IKGB105/LM2596-Adjustable-Buck-Converter/fem/figuras/12V_acercamiento_U1_D1.png

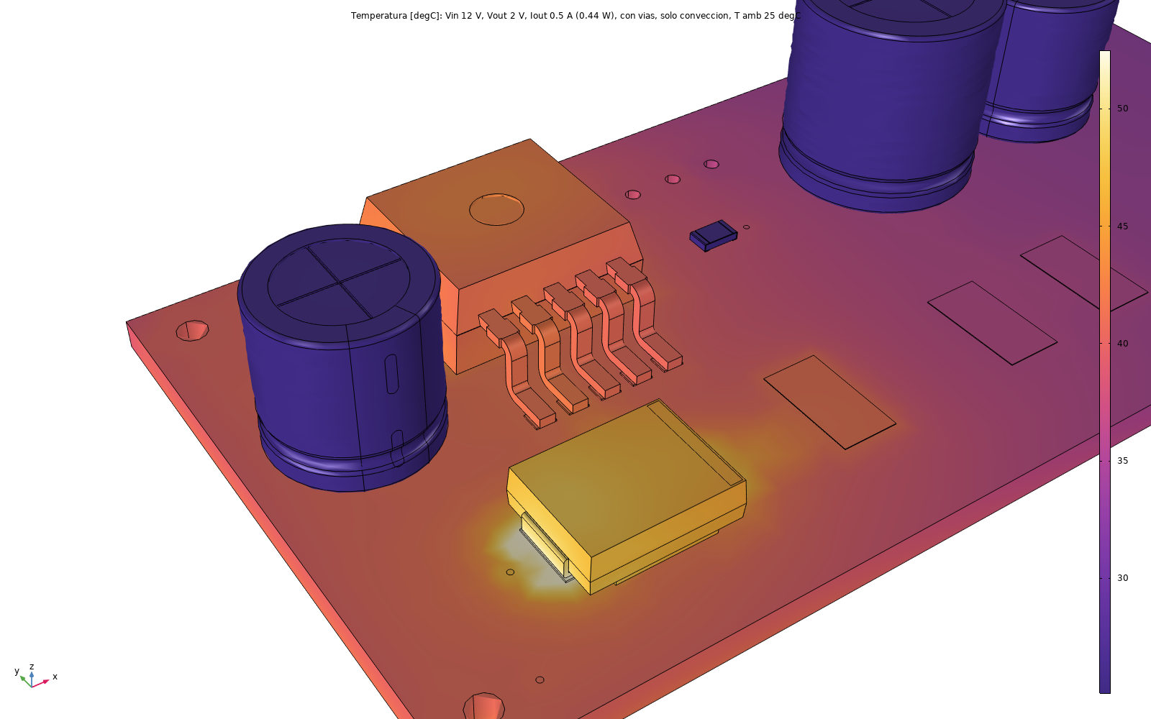
fem/figuras/12V_acercamiento_U1_D1.png
