IKGB105/LM2596-Adjustable-Buck-Converter/fem/figuras/12V_inferior.png

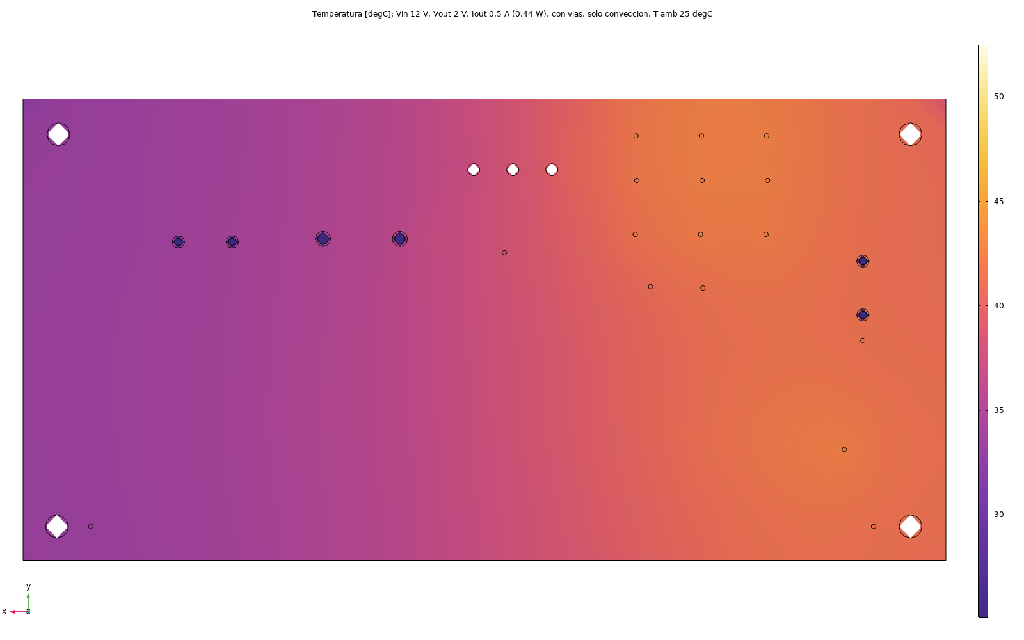
fem/figuras/12V_inferior.png
