IKGB105/LM2596-Adjustable-Buck-Converter/fem/figuras/aire_corte_temperatura.png

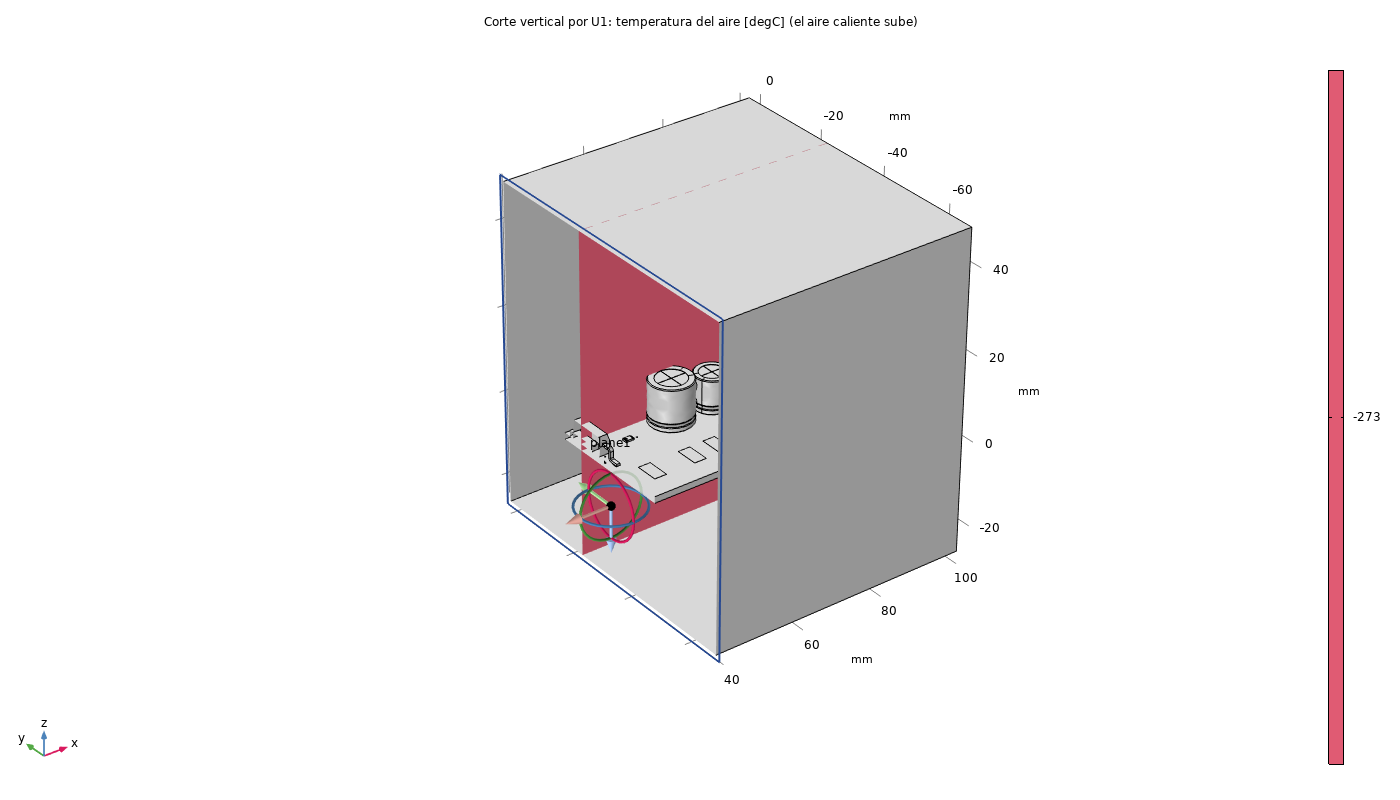
fem/figuras/aire_corte_temperatura.png
