IKGB105/LM2596-Adjustable-Buck-Converter/fem/geometria/LM259.step

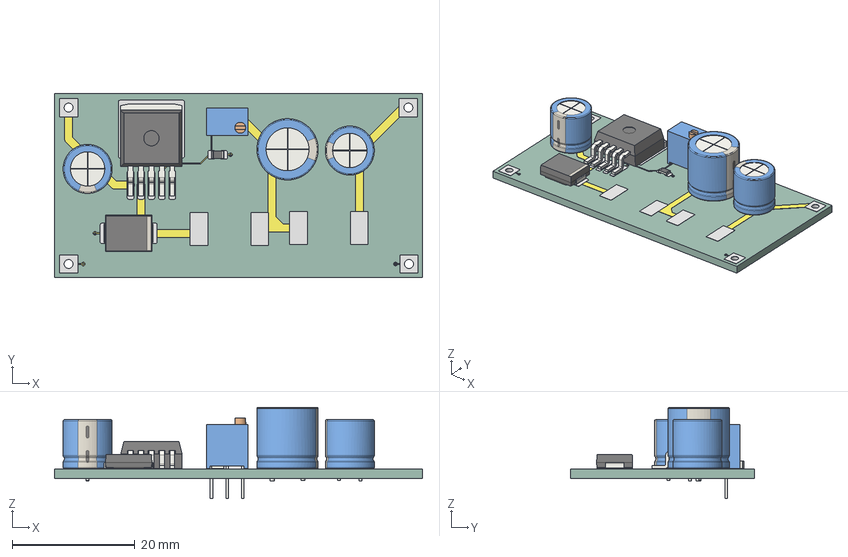
[picture p11: CAD file, 2026-10-22]
fem/geometria/LM259.step
60.0 x 30.0 x 14.9 mm
CP_Radial_D80mm_P350mm x 2
Potentiometer_Bourns_3266Y_Vertical
a648ce37-9c39-11ed-93f0-dde97e994e83_part
a648ce38-9c39-11ed-93f0-dde97e994e83_part
a648ce39-9c39-11ed-93f0-dde97e994e83_part
CP_Radial_D100mm_P500mm
R_0805_2012Metric
D_SMC
LM259-unsaved-export-bPfgib_copper
LM259-unsaved-export-bPfgib_pad
LM259-unsaved-export-bPfgib_via
LM259-unsaved-export-bPfgib_PCB
