IKGB105/LM2596-Adjustable-Buck-Converter/fem/geometria/Arreglo.step

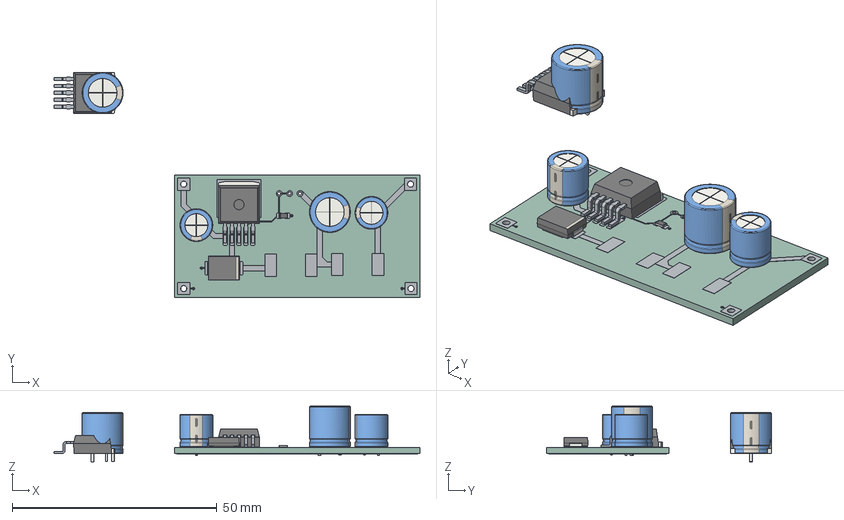
[picture p12: CAD file, 2026-10-22]
fem/geometria/Arreglo.step
89.4 x 55.0 x 13.6 mm
CP_Radial_D80mm_P350mm x 6
X-axis x 39
XY-plane x 39
a648ce37-9c39-11ed-93f0-dde97e994e83_part x 6
a648ce38-9c39-11ed-93f0-dde97e994e83_part x 6
a648ce39-9c39-11ed-93f0-dde97e994e83_part x 6
CP_Radial_D100mm_P500mm x 3
R_0805_2012Metric x 3
D_SMC x 3
LM259-unsaved-export-bPfgib_copper x 2
LM259-unsaved-export-bPfgib_pad x 2
LM259-unsaved-export-bPfgib_via x 2
LM259-unsaved-export-bPfgib_PCB x 2
