IKGB105/LM2596-Adjustable-Buck-Converter/fem/geometria/dominios_materiales_STEP.csv

dominio | material | que es
1 | FR4 (placa) | Placa
2 | Cobre (tab y pines de U1, pads de L1/L2) | Lamina de cobre (pista, pad o plano)
3 | Cobre (tab y pines de U1, pads de L1/L2) | Lamina de cobre (pista, pad o plano)
4 | Cobre (tab y pines de U1, pads de L1/L2) | Lamina de cobre (pista, pad o plano)
5 | Cobre (tab y pines de U1, pads de L1/L2) | Lamina de cobre (pista, pad o plano)
6 | Cobre (tab y pines de U1, pads de L1/L2) | Lamina de cobre (pista, pad o plano)
7 | Cobre (tab y pines de U1, pads de L1/L2) | Lamina de cobre (pista, pad o plano)
8 | Cobre (tab y pines de U1, pads de L1/L2) | Lamina de cobre (pista, pad o plano)
9 | Cobre (tab y pines de U1, pads de L1/L2) | Lamina de cobre (pista, pad o plano)
10 | Cobre (tab y pines de U1, pads de L1/L2) | Barril de agujero THT (diam 1.50 mm)
11 | Cobre (tab y pines de U1, pads de L1/L2) | Lamina de cobre (pista, pad o plano)
12 | Cobre (tab y pines de U1, pads de L1/L2) | Lamina de cobre (pista, pad o plano)
13 | Cobre (tab y pines de U1, pads de L1/L2) | Lamina de cobre (pista, pad o plano)
14 | Cobre (tab y pines de U1, pads de L1/L2) | Lamina de cobre (pista, pad o plano)
15 | Cobre (tab y pines de U1, pads de L1/L2) | Barril de agujero THT (diam 1.50 mm)
16 | Cobre (tab y pines de U1, pads de L1/L2) | Lamina de cobre (pista, pad o plano)
17 | Cobre (tab y pines de U1, pads de L1/L2) | Lamina de cobre (pista, pad o plano)
18 | Relleno generico (C1-C3, R1) | Capacitor
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
187 | Cobre (tab y pines de U1, pads de L1/L2) | Lamina de cobre (pista, pad o plano)
188 | Cobre (tab y pines de U1, pads de L1/L2) | Lamina de cobre (pista, pad o plano)
189 | Cobre (tab y pines de U1, pads de L1/L2) | Lamina de cobre (pista, pad o plano)
190 | Cobre (tab y pines de U1, pads de L1/L2) | Lamina de cobre (pista, pad o plano)
191 | Cobre (tab y pines de U1, pads de L1/L2) | Lamina de cobre (pista, pad o plano)
192 | Cobre (tab y pines de U1, pads de L1/L2) | Lamina de cobre (pista, pad o plano)
193 | Cobre (tab y pines de U1, pads de L1/L2) | Barril de agujero THT (diam 1.50 mm)
194 | Cobre (tab y pines de U1, pads de L1/L2) | Lamina de cobre (pista, pad o plano)
195 | Cobre (tab y pines de U1, pads de L1/L2) | Lamina de cobre (pista, pad o plano)
196 | Cobre (tab y pines de U1, pads de L1/L2) | Barril de agujero THT (diam 1.50 mm)
197 | Cobre (tab y pines de U1, pads de L1/L2) | Lamina de cobre (pista, pad o plano)
198 | Cobre (tab y pines de U1, pads de L1/L2) | Lamina de cobre (pista, pad o plano)
199 | Cobre (tab y pines de U1, pads de L1/L2) | Lamina de cobre (pista, pad o plano)
