IKGB105/LM2596-Adjustable-Buck-Converter/fem/resultados/barrido_corriente.csv

Iout [A] | P_U1 [W] | P_D1 [W] | P_L1 [W] | P_L2 [W] | P_tot [W] | T union U1 (cara tab-cuerpo) [degC] | T max U1 [degC] | T max D1 [degC] | T max placa [degC] | T max en todo [degC]
0.5 | 0.335 | 0.237 | 0.010 | 0.006 | 0.589 | 50.4 | 50.4 | 58.9 | 58.9 | 58.9
1 | 0.496 | 0.475 | 0.040 | 0.025 | 1.036 | 63.8 | 63.8 | 85.4 | 85.4 | 85.4
1.5 | 0.656 | 0.712 | 0.090 | 0.056 | 1.515 | 77.0 | 77.0 | 111.4 | 111.3 | 111.4
2 | 0.817 | 0.950 | 0.160 | 0.100 | 2.026 | 90.0 | 90.0 | 136.9 | 136.9 | 136.9
2.5 | 0.977 | 1.187 | 0.250 | 0.156 | 2.571 | 103.1 | 103.1 | 162.5 | 162.4 | 162.5
3 | 1.138 | 1.424 | 0.360 | 0.225 | 3.147 | 116.2 | 116.2 | 187.9 | 187.8 | 187.9
