IKGB105/LM2596-Adjustable-Buck-Converter/fem/resultados/variantes.csv

variante | T union U1 (cara tab-cuerpo) [degC] | T max U1 [degC] | T max D1 [degC] | T max placa [degC] | T max en todo [degC]
Con vias (base) | 116.2 | 116.2 | 187.9 | 187.8 | 187.9
Sin vias | 123.8 | 123.8 | 205.2 | 205.0 | 205.2
Con vias + radiacion (eps 0.9) | 89.3 | 89.3 | 155.8 | 155.7 | 155.8
Sin vias + radiacion (eps 0.9) | 96.7 | 96.7 | 170.6 | 170.5 | 170.6
Con vias, sin perdidas en L1/L2 | 108.5 | 108.5 | 180.6 | 180.5 | 180.6
