IKGB105/LM2596-Adjustable-Buck-Converter/LM259/LM259.kicad_pcb

## KiCad design LM259/LM259.kicad_pcb (2026-10-22)

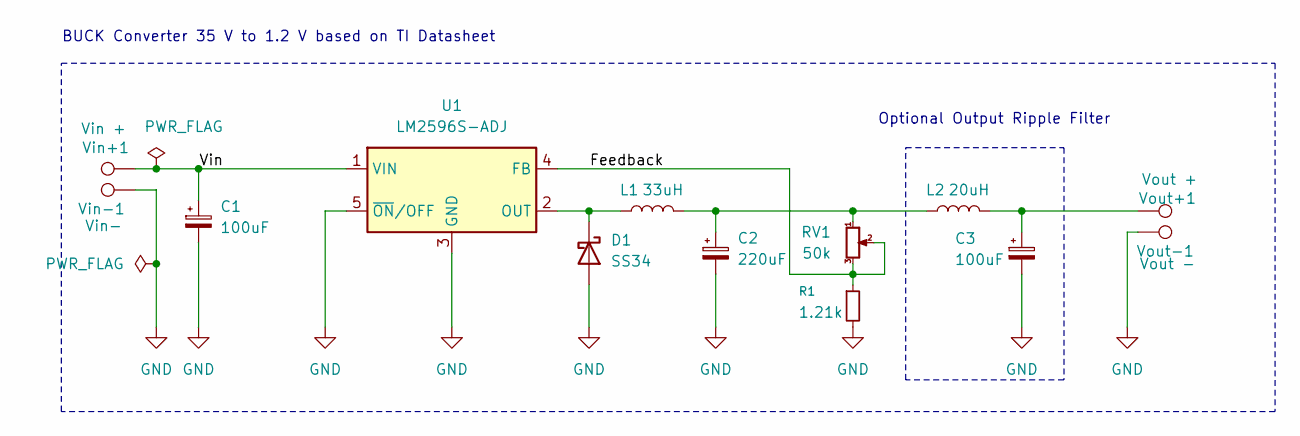
[picture p13: schematic LM259.kicad_sch]

Parts:
C1, C3: 100uF; CP_Radial_D8.0mm_P3.50mm
C2: 220uF; CP_Radial_D10.0mm_P5.00mm
D1: SS34; D_SMC
L1: 33uH; L_12x12mm_H4.5mm
L2: 20uH; L_12x12mm_H4.5mm
R1: 1.21k; R_0805_2012Metric_Pad1.20x1.40mm_HandSolder
RV1: 50k; Potentiometer_Bourns_3266Y_Vertical
U1: LM2596S-ADJ; TO-263-5_TabPin3
Vin+1: Vin +; TestPoint_THTPad_3.0x3.0mm_Drill1.5mm
Vin-1: Vin-; TestPoint_THTPad_3.0x3.0mm_Drill1.5mm
Vout+1: Vout +; TestPoint_THTPad_3.0x3.0mm_Drill1.5mm
Vout-1: Vout -; TestPoint_THTPad_3.0x3.0mm_Drill1.5mm

Connections:
/Feedback: R1.1, RV1.2, RV1.3, U1.4 (FB)
/Vin: C1.1, U1.1 (VIN), Vin+1.1 (1_1)
GND: C1.2, C2.2, C3.2, D1.2 (A), R1.2, U1.3 (GND), U1.5 (~ON/OFF), Vin-1.1 (1_1), Vout-1.1 (1_1)
unnamed: C2.1, L1.2, L2.1, RV1.1
unnamed: C3.1, L2.2, Vout+1.1 (1_1)
unnamed: D1.1 (K), L1.1, U1.2 (OUT)

Notes on the sheet:
BUCK Converter 35 V to 1.2 V based on TI Datasheet
Optional Output Ripple Filter

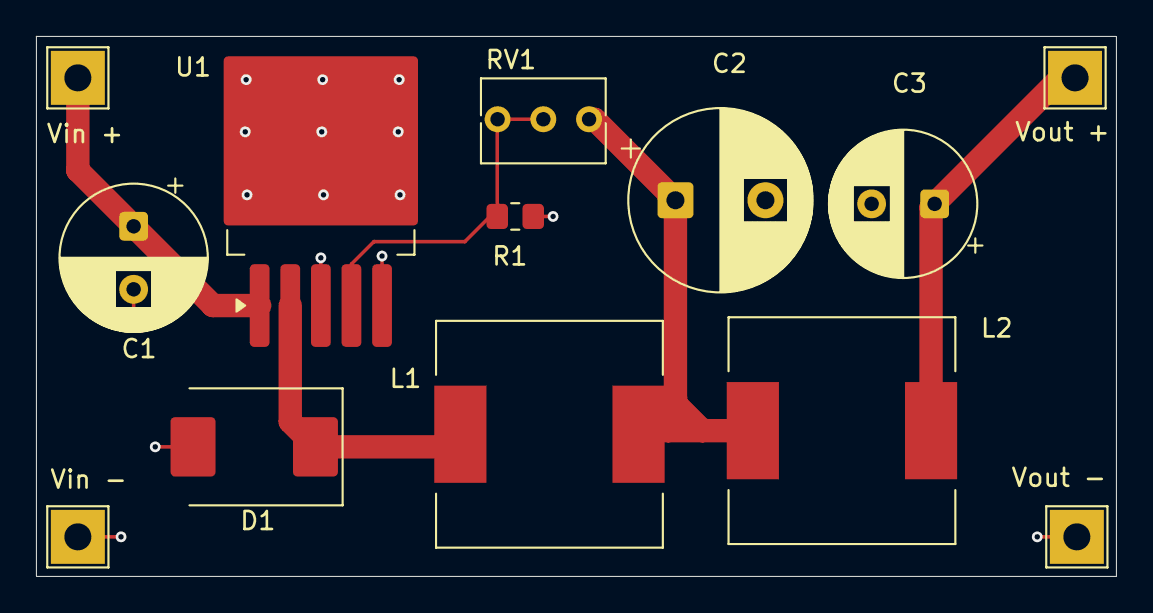
[picture p14: board LM259.kicad_pcb from above]

Board: 2 copper layers, 60.0 x 30.0 mm, 13 parts (0 on the bottom side), 6 nets.
