IKGB105/LM2596-Adjustable-Buck-Converter/(commit log)

2026-10-22 Initial commit: LM2596 adjustable buck converter
    - KiCad schematic/PCB (LM259/), ERC and DRC clean, 2-layer board
    - COMSOL thermal validation (fem/): demonstration point (12V->2V, 0.5A)
    and a worst-case sweep (35V->1.23V, 0.5-3A) identifying D1 as the
    real thermal limit, with via-stitching and radiation variants
    - Full report with methodology, materials, debugging log, and the
    D1 root-cause finding (docs/lm2596_buck.tex, compiled PDF included)
    - A conjugate heat-transfer (simulated air) cross-check was attempted
    and did not converge; documented as not adopted, no number from it
    is used in the report
    [Arreglo.step, LM259.kicad_pcb, LM259.kicad_sch, LM259.step, barrido_corriente.csv, caso_12V_2V_05A.csv, caso_12V_2V_05A_aire.csv, caso_nominal.csv]
2026-10-22 Add KiCad schematic/3D render figures, fix the LM317 cross-link, match README structure to the sibling repo
2026-10-22 Change on Schematic
